ccreutzig/prompter/README.md

# prompter (with lights)

Project goal: For a puppetteer's stage, control both a text display on an Android tablet and LED lighting for the stage.

More details to follow.

Project stage: collecting requirements
