ccreutzig/prompter/Hardware/prompter.kicad_pcb

## KiCad design Hardware/prompter.kicad_pcb (2020-11-26)

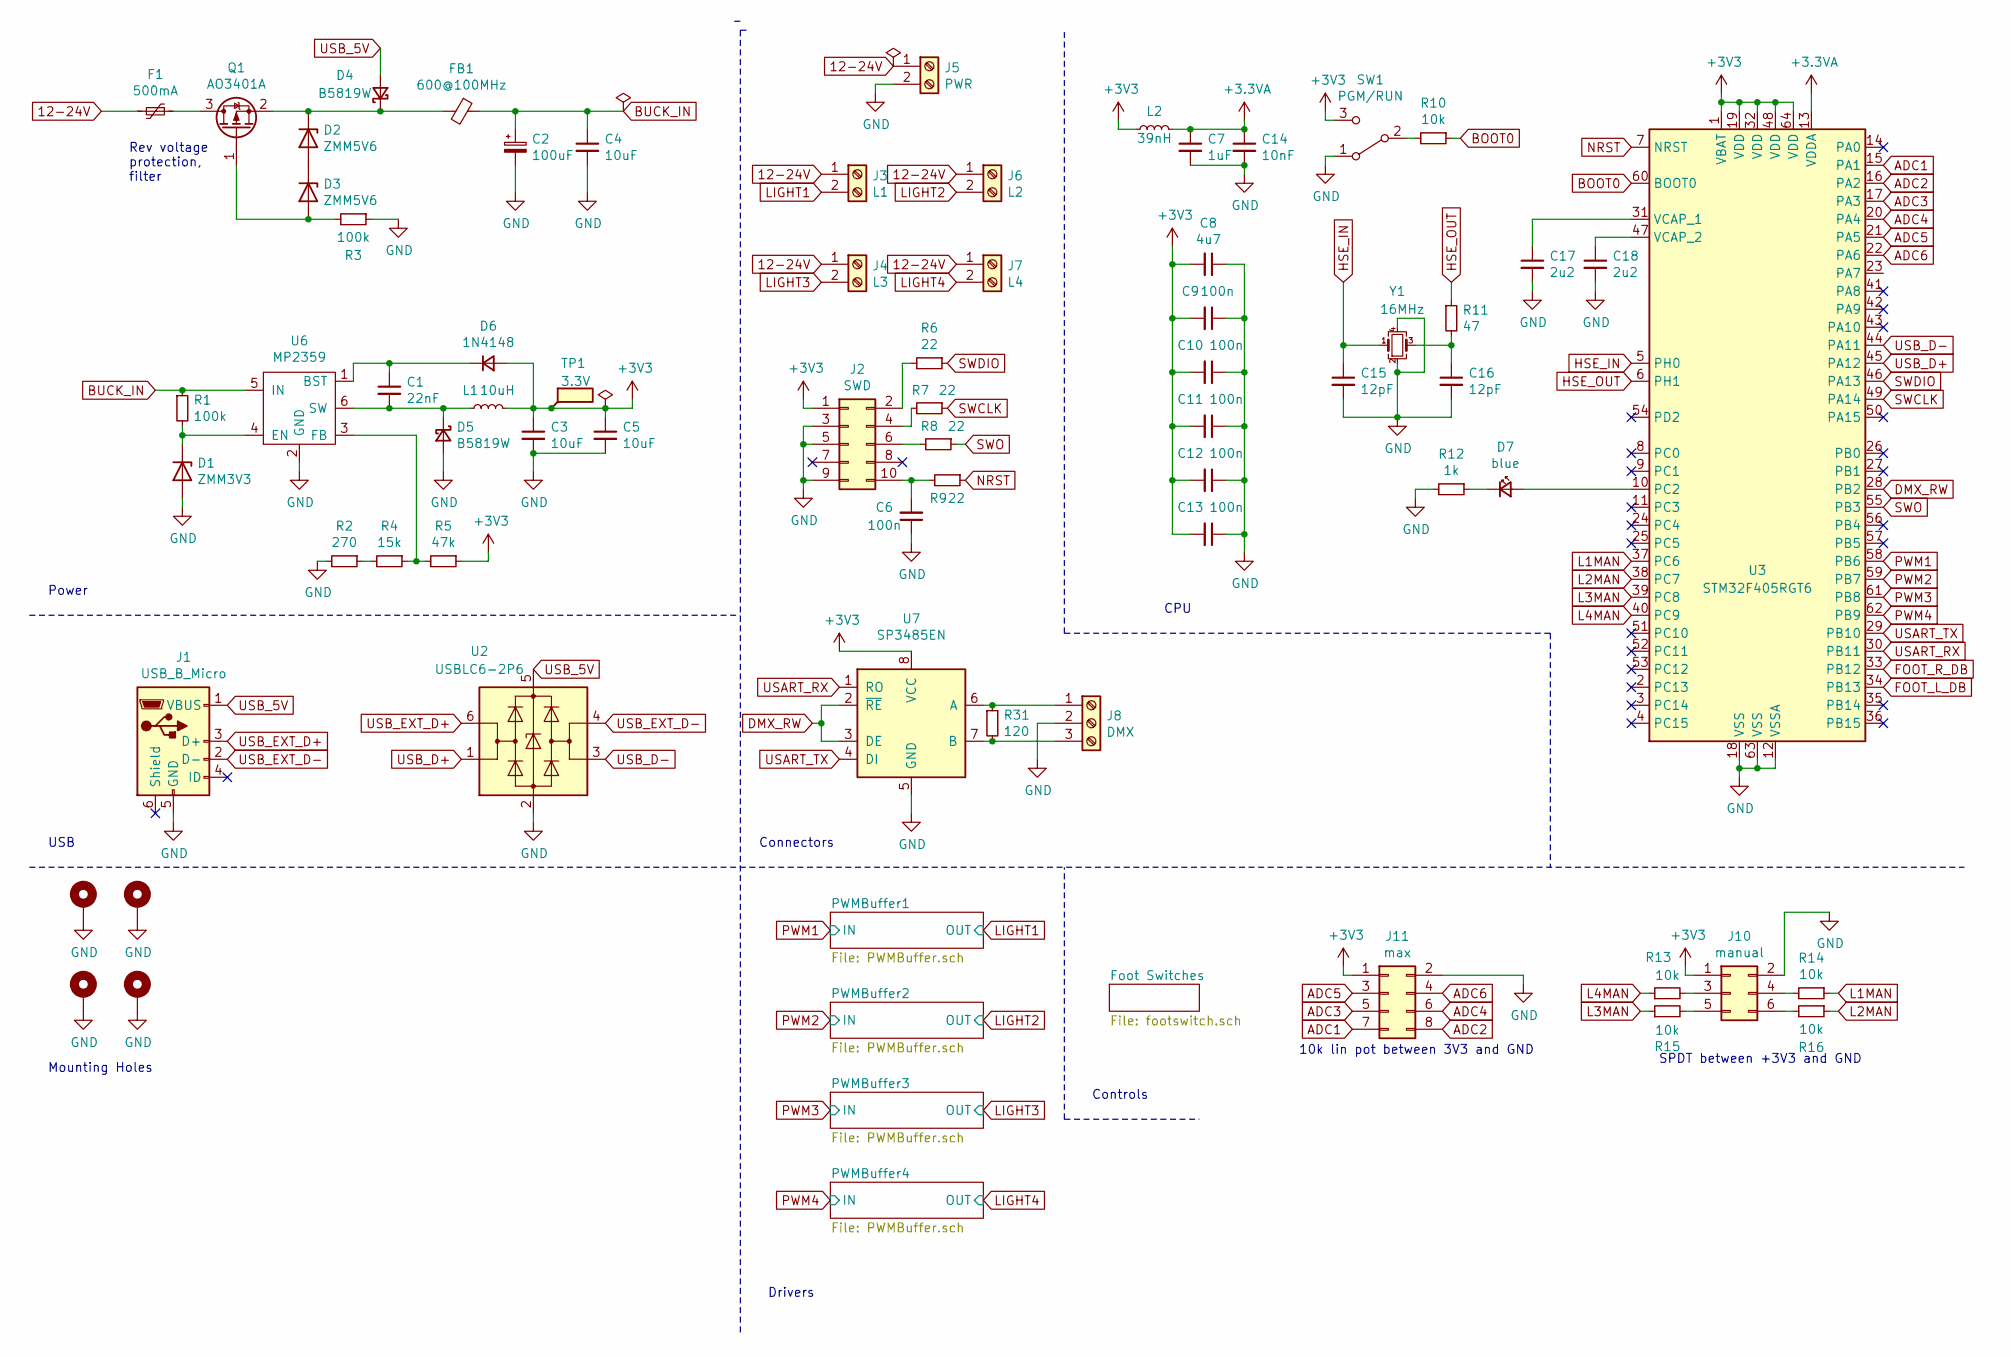
[picture p1: schematic prompter.sch]

Parts:
C1: 22nF; C_0805; LCSC C1729
C2: 100uF; CP_Tantalum_Case-B_EIA-3528-21_Reflow; LCSC C16133
C3, C4, C5: 10uF; C_1206; LCSC C13585
C6: 100n; C_0402
C7: 1uF; C_0402; LCSC C52923
C8: 4u7; C_0603; LCSC C19666
C9, C10, C11, C12, C13: 100n; C_0402; LCSC C1525
C14: 10nF; C_0402; LCSC C15195
C15, C16: 12pF; C_0402; LCSC C1547
C17, C18: 2u2; C_0603; LCSC C23630
D1: ZMM3V3; D_MiniMELF; LCSC C8056
D2, D3: ZMM5V6; D_MiniMELF; LCSC C8062
D4, D5: B5819W; D_SOD-123; LCSC C8598
D6: 1N4148; D_SOD-123; LCSC C81598
D7: blue; LED_0603; LCSC C72041
F1: 500mA; R_1812_HandSoldering
FB1: 600@100MHz; R_0805_HandSoldering; LCSC C1017
H1, H2, H3, H4: MountingHole_Pad; MountingHole_4.3x6.2mm_M4_Pad_Via
J1: USB_B_Micro; USB_Micro-B
J2: SWD; Pin_Header_Straight_2x05_Pitch2.54mm
J3: L1; PhoenixContact_MCV-G_02x3.50mm_Vertical
J4: L3; PhoenixContact_MCV-G_02x3.50mm_Vertical
J5: PWR; PhoenixContact_MCV-G_02x3.50mm_Vertical
J6: L2; PhoenixContact_MCV-G_02x3.50mm_Vertical
J7: L4; PhoenixContact_MCV-G_02x3.50mm_Vertical
J8: DMX; PhoenixContact_MCV-G_03x3.50mm_Vertical
J10: manual; Pin_Header_Straight_2x03_Pitch2.54mm
J11: max; Pin_Header_Straight_2x04_Pitch2.54mm
L1: 10uH; Neosid_Inductor_Ms50
L2: 39nH; R_0402; LCSC C86063
Q1: AO3401A; SOT-23; LCSC C15127
R1, R3: 100k; R_0603; LCSC C25803
R2: 270; R_0603; LCSC C22966
R4: 15k; R_0603; LCSC C22809
R5: 47k; R_0603; LCSC C25819
R6, R7, R8, R9: 22; R_0402; LCSC C25092
R10, R13, R14, R15, R16: 10k; R_0402; LCSC C25744
R11: 47; R_0402; LCSC C25118
R12: 1k; R_0603; LCSC C21190
R31: 120; R_0402; LCSC C25079
SW1: PGM/RUN; Pin_Header_Straight_1x03_Pitch2.54mm
TP1: 3.3V; Measurement_Point_Round-SMD-Pad_Small
U2: USBLC6-2P6; SOT-666; LCSC C15999
U3: STM32F405RGT6; LQFP-64-1EP_10x10mm_Pitch0.5mm; LCSC C15742
U6: MP2359; TSOT-23-6; LCSC C14259
U7: SP3485EN; SOIC-8_3.9x4.9mm_Pitch1.27mm; LCSC C8963
Y1: 16MHz; Crystal_SMD_3225-4pin_3.2x2.5mm; LCSC C13738

Connections:
12-24V: F1.2, J3.1, J4.1, J5.1, J6.1, J7.1; also elsewhere on the board
+3.3VA: C7.1, C14.1, L2.2, U3.13 (VDDA)
+3V3: C3.1, C5.1, C8.2, C9.2, C10.2, C11.2, C12.2, C13.2, D6.2 (A), J2.1, J10.1, J11.1, L1.2, L2.1, R5.1, SW1.3 (C), TP1.1, U3.1 (VBAT), U3.19 (VDD), U3.32 (VDD), U3.48 (VDD), U3.64 (VDD), U7.8 (VCC); also elsewhere on the board
ADC1: J11.7, U3.15 (PA1)
ADC2: J11.8, U3.16 (PA2)
ADC3: J11.5, U3.17 (PA3)
ADC4: J11.6, U3.20 (PA4)
ADC5: J11.3, U3.21 (PA5)
ADC6: J11.4, U3.22 (PA6)
BOOT0: R10.1, U3.60 (BOOT0)
BUCK_IN: C2.1, C4.1, FB1.1, R1.1, U6.5 (IN)
DMX_RW: U3.28 (PB2), U7.2 (~RE~), U7.3 (DE)
FOOT_L_DB: U3.34 (PB13); also elsewhere on the board
FOOT_R_DB: U3.33 (PB12); also elsewhere on the board
GND: C2.2, C3.2, C4.2, C5.2, C6.1, C7.2, C8.1, C9.1, C10.1, C11.1, C12.1, C13.1, C14.2, C15.2, C16.2, C17.2, C18.2, D1.2 (A), D5.2 (A), H1.1, H2.1, H3.1, H4.1, J1.5 (GND), J2.3, J2.5, J2.9, J5.2, J8.2, J10.2, J11.2, R2.2, R3.1, R12.2, SW1.1 (A), U2.2 (GND), U3.12 (VSSA), U3.18 (VSS), U3.63 (VSS), U6.2 (GND), U7.5 (GND), Y1.2, Y1.4; also elsewhere on the board
HSE_IN: C15.1, U3.5 (PH0), Y1.1
HSE_OUT: R11.1, U3.6 (PH1)
L1MAN: R14.1, U3.37 (PC6)
L2MAN: R16.1, U3.38 (PC7)
L3MAN: R15.1, U3.39 (PC8)
L4MAN: R13.1, U3.40 (PC9)
LIGHT1: J3.2; also elsewhere on the board
LIGHT2: J6.2; also elsewhere on the board
LIGHT3: J4.2; also elsewhere on the board
LIGHT4: J7.2; also elsewhere on the board
NRST: R9.1, U3.7 (NRST)
unnamed: C1.1, D6.1 (K), U6.1 (BST)
unnamed: C1.2, D5.1 (K), L1.1, U6.6 (SW)
unnamed: C6.2, J2.10, R9.2
unnamed: C16.1, R11.2, Y1.3
unnamed: C17.1, U3.31 (VCAP_1)
unnamed: C18.1, U3.47 (VCAP_2)
unnamed: D1.1 (K), R1.2, U6.4 (EN)
unnamed: D2.1 (K), D4.1 (K), FB1.2, Q1.2 (S)
unnamed: D2.2 (A), D3.1 (K)
unnamed: D3.2 (A), Q1.1 (G), R3.2
unnamed: D7.1 (K), R12.1
unnamed: D7.2 (A), U3.10 (PC2)
unnamed: F1.1, Q1.3 (D)
unnamed: J2.2, R6.2
unnamed: J2.4, R7.2
unnamed: J2.6, R8.2
unnamed: J8.1, R31.1, U7.6 (A)
unnamed: J8.3, R31.2, U7.7 (B)
unnamed: J10.3, R13.2
unnamed: J10.4, R14.2
unnamed: J10.5, R15.2
unnamed: J10.6, R16.2
unnamed: R2.1, R4.2
unnamed: R4.1, R5.2, U6.3 (FB)
unnamed: R10.2, SW1.2 (B)
PWM1: U3.58 (PB6); also elsewhere on the board
PWM2: U3.59 (PB7); also elsewhere on the board
PWM3: U3.61 (PB8); also elsewhere on the board
PWM4: U3.62 (PB9); also elsewhere on the board
SWCLK: R7.1, U3.49 (PA14)
SWDIO: R6.1, U3.46 (PA13)
SWO: R8.1, U3.55 (PB3)
USART_RX: U3.30 (PB11), U7.1 (RO)
USART_TX: U3.29 (PB10), U7.4 (DI)
USB_5V: D4.2 (A), J1.1 (VBUS), U2.5 (VBUS)
USB_D+: U2.1 (I/O1), U3.45 (PA12)
USB_D-: U2.3 (I/O2), U3.44 (PA11)
USB_EXT_D+: J1.3 (D+), U2.6 (I/O1)
USB_EXT_D-: J1.2 (D-), U2.4 (I/O2)

Notes on the sheet:
Rev voltage protection, filter
Power
CPU
USB
Connectors
Controls
Drivers
Mounting Holes
10k lin pot between 3V3 and GND
SPDT between +3V3 and GND

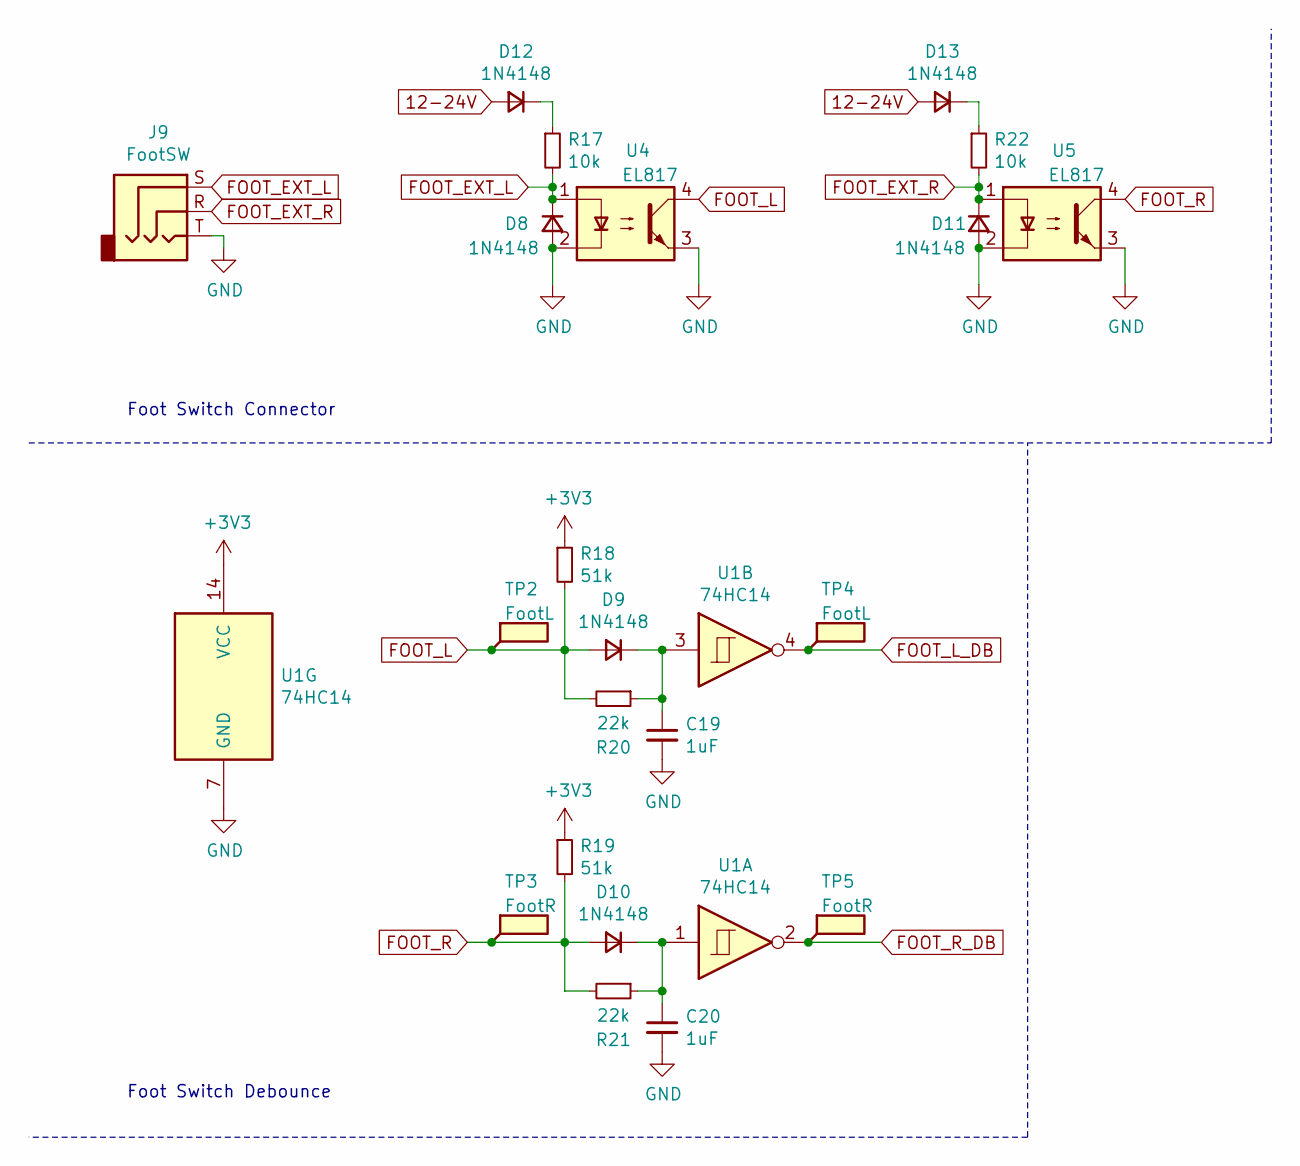
[picture p2: schematic footswitch.sch]

Parts:
C19, C20: 1uF; C_0402; LCSC C52923
D8, D9, D10, D11, D12, D13: 1N4148; D_SOD-123; LCSC C81598
J9: FootSW; Audio_Jack_6.35mm
R17, R22: 10k; R_0603; LCSC C25804
R18, R19: 51k; R_0402; LCSC C25794
R20, R21: 22k; R_0402; LCSC C25768
TP2, TP4: FootL; Measurement_Point_Round-SMD-Pad_Small
TP3, TP5: FootR; Measurement_Point_Round-SMD-Pad_Small
U1: 74HC14; SOIC-14_3.9x8.7mm_Pitch1.27mm; LCSC C5605
U4, U5: EL817; SO-4_7.6x3.6mm_Pitch2.54mm; LCSC C106900

Connections:
12-24V: D12.2 (A), D13.2 (A); also elsewhere on the board
+3V3: R18.1, R19.1, U1.14 (VCC); also elsewhere on the board
FOOT_EXT_L: D8.1 (K), J9.S, R17.2, U4.1
FOOT_EXT_R: D11.1 (K), J9.R, R22.2, U5.1
FOOT_L: D9.2 (A), R18.2, R20.2, TP2.1, U4.4
FOOT_L_DB: TP4.1, U1.4; also elsewhere on the board
FOOT_R: D10.2 (A), R19.2, R21.2, TP3.1, U5.4
FOOT_R_DB: TP5.1, U1.2; also elsewhere on the board
GND: C19.2, C20.2, D8.2 (A), D11.2 (A), J9.T, U1.7 (GND), U4.2, U4.3, U5.2, U5.3; also elsewhere on the board
unnamed: C19.1, D9.1 (K), R20.1, U1.3
unnamed: C20.1, D10.1 (K), R21.1, U1.1
unnamed: D12.1 (K), R17.1
unnamed: D13.1 (K), R22.1

Notes on the sheet:
Foot Switch Debounce
Foot Switch Connector

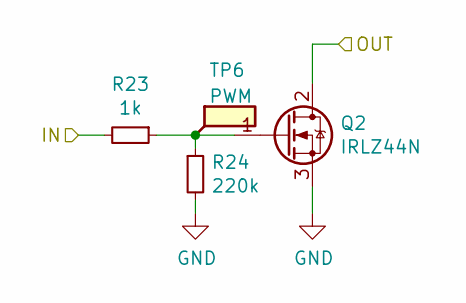
[picture p3: schematic PWMBuffer.sch]

Parts:
Q2: IRLZ44N; TO-220-3_Vertical
R23: 1k; R_0402; LCSC C11702
R24: 220k; R_0402; LCSC C25767
TP6: PWM; Measurement_Point_Round-SMD-Pad_Small

Connections:
GND: Q2.3 (S), R24.2; also elsewhere on the board
LIGHT1: Q2.2 (D); also elsewhere on the board
unnamed: Q2.1 (G), R23.1, R24.1, TP6.1
PWM1: R23.2; also elsewhere on the board

Parts of its further copies:
Q3, Q4, Q5: IRLZ44N; TO-220-3_Vertical
R25, R27, R29: 1k; R_0402; LCSC C11702
R26, R28, R30: 220k; R_0402; LCSC C25767
TP7, TP8, TP9: PWM; Measurement_Point_Round-SMD-Pad_Small

Connections of its further copies:
GND: Q3.3 (S), Q4.3 (S), Q5.3 (S), R26.2, R28.2, R30.2; also elsewhere on the board
LIGHT2: Q3.2 (D); also elsewhere on the board
LIGHT3: Q4.2 (D); also elsewhere on the board
LIGHT4: Q5.2 (D); also elsewhere on the board
unnamed: Q3.1 (G), R25.1, R26.1, TP7.1
unnamed: Q4.1 (G), R27.1, R28.1, TP8.1
unnamed: Q5.1 (G), R29.1, R30.1, TP9.1
PWM2: R25.2; also elsewhere on the board
PWM3: R27.2; also elsewhere on the board
PWM4: R29.2; also elsewhere on the board

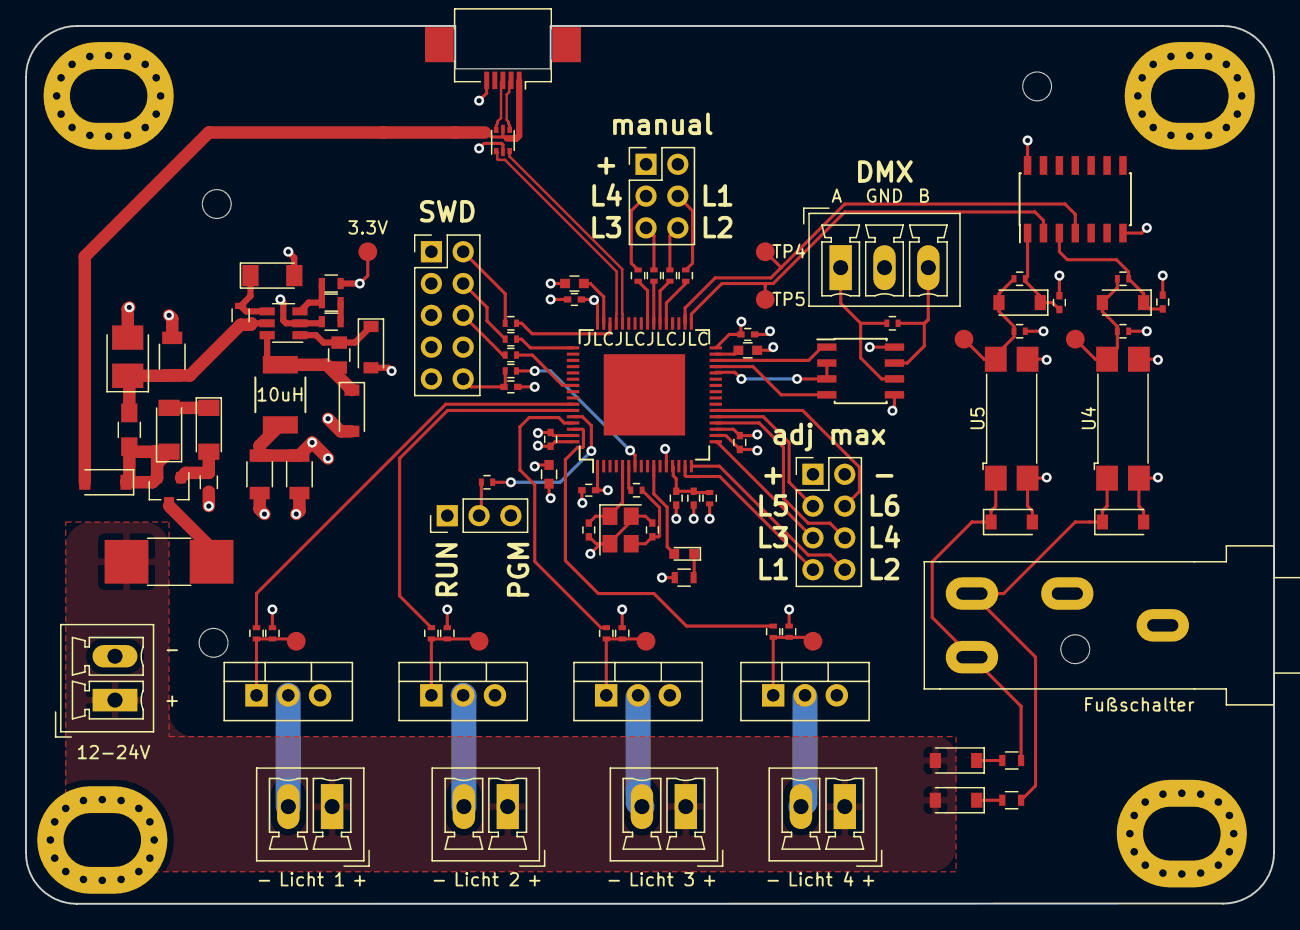
[picture p4: board prompter.kicad_pcb from above]

Board: 4 copper layers, 99.7 x 70.1 mm, 106 parts (0 on the bottom side), 77 nets.
