ccreutzig/prompter/Firmware/Core/Src/main.c

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
/* Includes ------------------------------------------------------------------*/
#include "main.h"
#include "usb_device.h"

ADC_HandleTypeDef hadc1;
DMA_HandleTypeDef hdma_adc1;

TIM_HandleTypeDef htim3;
TIM_HandleTypeDef htim4;

UART_HandleTypeDef huart3;

/* USER CODE BEGIN PV */
#define NR_POTS 4
#define ADC_LEN NR_POTS
uint16_t adcVals[ADC_LEN];

uint16_t knobValues[NR_POTS];

uint8_t softwareValues[NR_POTS];

/* USER CODE END PV */

void SystemClock_Config(void);
static void MX_GPIO_Init(void);
static void MX_DMA_Init(void);
static void MX_ADC1_Init(void);
static void MX_TIM4_Init(void);
static void MX_USART3_UART_Init(void);
static void MX_TIM3_Init(void);
/* USER CODE BEGIN 0 */

void checkUSBData() {
	if (dataFromUSBWaitingForProcessing) {
		char buffer[USB_BUFFER_LEN+1];
		memcpy(buffer,dataFromUSB,bytesReadFromUSB);
		const uint8_t bytesRead = bytesReadFromUSB;
		buffer[bytesRead] = '\0';
		// reset early, so USB callback can work
		bytesReadFromUSB = 0;
		dataFromUSBWaitingForProcessing = 0;

		if (bytesRead < 4) {
			return;
		}

		// commands:
		// Ln mmm
		// Set light n to mmm%
		if (buffer[0] == 'L') {
			int8_t channel = buffer[1] - '0';
			if (channel < 1 || channel > 4) {
				return;
			}
			uint8_t value = 0;
			int8_t k;
			for (k=3; buffer[k] >= '0' && buffer[k] <= '9'; ++k) {
				value *= 10;
				value += buffer[k] - '0';
			}
			softwareValues[channel-1] = value;
		}
	}
}

void updatePWM() {
	__HAL_TIM_SET_COMPARE(&htim4,TIM_CHANNEL_1,(4*knobValues[0]*softwareValues[0])/100);
	__HAL_TIM_SET_COMPARE(&htim4,TIM_CHANNEL_2,(4*knobValues[1]*softwareValues[1])/100);
	__HAL_TIM_SET_COMPARE(&htim4,TIM_CHANNEL_3,(4*knobValues[2]*softwareValues[2])/100);
	__HAL_TIM_SET_COMPARE(&htim4,TIM_CHANNEL_4,(4*knobValues[3]*softwareValues[3])/100);
}

/* USER CODE END 0 */

/**
  * @brief  The application entry point.
  * @retval int
  */
int main(void)
{
  /* MCU Configuration--------------------------------------------------------*/

  /* Reset of all peripherals, Initializes the Flash interface and the Systick. */
  HAL_Init();

  /* Configure the system clock */
  SystemClock_Config();

  /* Initialize all configured peripherals */
  MX_GPIO_Init();
  MX_DMA_Init();
  MX_ADC1_Init();
  MX_TIM4_Init();
  MX_USART3_UART_Init();
  MX_USB_DEVICE_Init();
  MX_TIM3_Init();
  /* USER CODE BEGIN 2 */
  HAL_ADC_Start_DMA(&hadc1, (uint32_t*)adcVals, ADC_LEN);
  HAL_TIM_Base_Start_IT(&htim3);
  HAL_TIM_Base_Start_IT(&htim4);

  softwareValues[0] = 100;
  softwareValues[1] = 100;
  softwareValues[2] = 100;
  softwareValues[3] = 100;
  HAL_GPIO_WritePin(Status_LED_GPIO_Port, Status_LED_Pin, GPIO_PIN_SET);
  HAL_Delay(1000);
  HAL_GPIO_WritePin(Status_LED_GPIO_Port, Status_LED_Pin, GPIO_PIN_RESET);
  /* USER CODE END 2 */

  /* Infinite loop */
  /* USER CODE BEGIN WHILE */
  while (1)
  {
	checkUSBData();

    updatePWM();
    /* USER CODE END WHILE */

    /* USER CODE BEGIN 3 */
  }
  /* USER CODE END 3 */
}

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
/* USER CODE BEGIN 4 */

// Called when buffer is completely filled
void HAL_ADC_ConvCpltCallback(ADC_HandleTypeDef* hadc) {
  if (hadc == &hadc1) {
	for (int k=0; k<NR_POTS; ++k) {
      knobValues[k] = adcVals[k];
	}
  }
}

void HAL_GPIO_EXTI_Callback(uint16_t GPIO_Pin)
{
	if (GPIO_Pin == Foot_L_Pin) {
		CDC_Transmit_FS("L", 1);
	}
	if (GPIO_Pin == Foot_R_Pin) {
		CDC_Transmit_FS("R", 1);
	}
}

/* USER CODE END 4 */
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
