ccreutzig/prompter/Firmware/Prompter.ioc

Mcu.UserName=STM32F405RGTx
PA1.Signal=ADCx_IN1
PA11.Signal=USB_OTG_FS_DM
PA12.Signal=USB_OTG_FS_DP
PA13.Signal=SYS_JTMS-SWDIO
PA14.Signal=SYS_JTCK-SWCLK
PA2.Signal=ADCx_IN2
PA3.Signal=ADCx_IN3
PA4.Signal=ADCx_IN4
PA5.Signal=ADCx_IN5
PA6.Signal=ADCx_IN6
PB10.Signal=USART3_TX
PB11.Signal=USART3_RX
PB12.GPIO_Label=Foot L
PB12.Signal=GPXTI12
PB13.GPIO_Label=Foot R
PB13.Signal=GPXTI13
PB2.GPIO_Label=DMX R/W
PB2.Signal=GPIO_Output
PB3.Signal=SYS_JTDO-SWO
PB6.GPIO_Label=PWM1
PB6.Signal=S_TIM4_CH1
PB7.GPIO_Label=PWM2
PB7.Signal=S_TIM4_CH2
PB8.GPIO_Label=PWM3
PB8.Signal=S_TIM4_CH3
PB9.GPIO_Label=PWM4
PB9.Signal=S_TIM4_CH4
PC2.GPIO_Label=Status LED
PC2.Signal=GPIO_Output
PC6.GPIO_Label=L1MAN
PC6.Signal=GPIO_Input
PC7.GPIO_Label=L2MAN
PC7.Signal=GPIO_Input
PC8.GPIO_Label=L3MAN
PC8.Signal=GPIO_Input
PC9.GPIO_Label=L4MAN
PC9.Signal=GPIO_Input
PH0-OSC_IN.Signal=RCC_OSC_IN
PH1-OSC_OUT.Signal=RCC_OSC_OUT
