ccreutzig/prompter/Firmware/Core/Inc/main.h

#define Status_LED_Pin GPIO_PIN_2
#define Status_LED_GPIO_Port GPIOC
#define DMX_R_W_Pin GPIO_PIN_2
#define DMX_R_W_GPIO_Port GPIOB
#define Foot_L_Pin GPIO_PIN_12
#define Foot_L_GPIO_Port GPIOB
#define Foot_L_EXTI_IRQn EXTI15_10_IRQn
#define Foot_R_Pin GPIO_PIN_13
#define Foot_R_GPIO_Port GPIOB
#define Foot_R_EXTI_IRQn EXTI15_10_IRQn
#define L1MAN_Pin GPIO_PIN_6
#define L1MAN_GPIO_Port GPIOC
#define L2MAN_Pin GPIO_PIN_7
#define L2MAN_GPIO_Port GPIOC
#define L3MAN_Pin GPIO_PIN_8
#define L3MAN_GPIO_Port GPIOC
#define L4MAN_Pin GPIO_PIN_9
#define L4MAN_GPIO_Port GPIOC
#define PWM1_Pin GPIO_PIN_6
#define PWM1_GPIO_Port GPIOB
#define PWM2_Pin GPIO_PIN_7
#define PWM2_GPIO_Port GPIOB
#define PWM3_Pin GPIO_PIN_8
#define PWM3_GPIO_Port GPIOB
#define PWM4_Pin GPIO_PIN_9
#define PWM4_GPIO_Port GPIOB
