ccreutzig/prompter/(commit log)

2020-10-24 First draft, WIP
    [PWMBuffer.sch, footswitch.sch, prompter.kicad_pcb, prompter.sch]
2020-10-25 for future extension, also added DMX hardware
    [prompter.kicad_pcb, prompter.sch]
2020-11-07 Board updates:
    Fixed footprints (SMD vs. THT, no hanging pads in the air)
    Added mounting holes for production
    Moved F.Fab text to readable locations
    [PWMBuffer.sch, footswitch.sch, prompter.kicad_pcb, prompter.sch]
2020-11-26 Hardware v0.1, Firmware runs ADC trigger by TIM3
    [PWMBuffer.sch, footswitch.sch, prompter.kicad_pcb, prompter.sch]
2020-11-30 bare essentials USB communication
    host -> device: "Ln mmm\n" sets channel n to mmm%
    device -> host: "L" or "R" for foot switch contact
